TeguhTeknisi/ESP-Power-Monitor-with-INA226/README.md

# ESP-Power-Monitor-with-INA226
Bismillah

<b>ESP8266 Power Monitor with INA226</b> adalah alat ukur voltase, arus, daya dan energi dengan tambahan modul DHT11 untuk ukur temperatur dan kelembaban.
Alat ini dibuat sesuai kebutuhan sistem plts di tempat ana, dan ana tidak men jamin bisa jalan di tempat lain.
Alat ini kurang cocok untuk mengukur ke beban Inverter yang banyak Noise nya.

📣 Harus pakai Server Blynk Lokal , tutorial ada disini https://github.com/TeguhTeknisi/blynk-server
Sekedar info, ana install server blynk ke laptop ubuntu linux, tapi bisa juga di install ke android yang di instali linux.
Tambahan, Kalau mau pakai Server Online, silahkan modif codenya.

✔️ Kode dan Skema ada 2 versi:
1. versi 1 sensor, supaya lebih murah bisa pakai Modul Sensor INA226 dengan R Shunt R002 dengan kemampuan ukur continue 20 Ampere max 35 Volt.
   --> versi ini hanya mengukur 1 sumber saja, dan bisa hemat sekitar 80rb karena tidak perlu beli Modul INA226 yang kedua + R Shunt FL4.
2. versi 2 sensor, ini untuk yang ingin mengukur 2 sumber, seperti yang ana pakai, untuk ukur sumber dari Output Scc dan Baterai ke Beban. 
   --> Kemampuan Ukur pada Modul Sensor INA226 yang kedua ana tambahkan RShunt FL4 50A 75mV, sehingga bisa ukur beban sampai 50A 35 Volt
   --> Dengan R Shunt FL4 50A bisa 1.400 Watt untuk sistem 28 Volt yang ana pakai.
   --> Bisa diganti ke R Shunt 100A, 150A, 200A, 250A tapi harus ganti code nya dan hati hati jika bekerja dengan Arus besar.

⛔ Code harus di edit pada:
1. Auth Token Blynk
2. Nama SSID Hotspot dan Password nya.

📣 Untuk memudahkan kompile, sudah ana sediakan file <b>libraries.zip</b> dan <b>libraries.tar.gz</b> ( pilih salah satu, cuma beda ekstensi saja )
Isi file nya adalah library untuk Blynk, INA226, LCD I2C PCF8574 dan DHT11

📣 Untuk tingkat akurasinya sudah cukup bagus menurut ana, dengan membandingkan pengukuran arus dan voltase pakai multimeter Zoyi ZT102A
Karena R Shunt akan panas, jika arus besar lewat, maka panas nya akan menyebar ke chip ic INA226 itu akan membuat pengukuran voltase dari INA226 nya jadi tidak akurat, jadi Solusinya, ana tambahkan metode pengukuran memakai ADC dan untuk Solusi lain nya, R Shunt sebaiknya di jauhkan dari Chip IC INA226 dengan kabel yang panjangnya minimal 10cm sampai 15 cm )

📣 Untuk Sensor INA226 beli di link yang ana kasih dibawah, Insya Allah terjamin.
Untuk part lain, hanya sebagai referensi harga, ana tidak menjamin kualitasnya.

⛔ HATI HATI, ada modul INA226 Palsu, ana pernah beli dan gak bisa didetek I2C nya pakai I2C Scanner, tapi pas di ganti alamat ke 0x50 bisa detek tapi hanya tampil pengukuran Voltase tapi gak bisa dipakai buat ukur voltase.
NodeMCU dan Wemos D1 juga mulai muncul dengan raqgam kualitas yang gak bisa dilihat dari harga, bisa murah atau mahal.
Biasanya buat upload code akan sering error karena kualitas Chip Flash nya yang kurang bagus, atau yang parah gak bisa di program karena Chip Flash nya rusak.

✔️ Kemampuan membaca Voltase Max 35 volt, disarankan 30 Volt
✔️ Kemampuan membaca Arus tergantung nilai R Shunt.
Untuk Kode nya ana seting untuk:
1. Sensor 1 Continue max 20A, peak 25A pakai INA226 dengan R Shunt SMD R002
2. Sensor 2 Continue max 50A, pakai INA226 dengan RShunt SMD R100 yang di sambung ke R Shunt Eksternal FL4 50A 75mV

☑️ Kit ESP8266 bisa pakai Wemos D1 Mini agar kecil ringkas, atau pakai NodeMCU bentuk agak besar, ana pakai NodeMCU

☑️ Modul LCD 1602 pakai IC I2C PCF8574  untuk IC versi lain, silahkan memakai atau mencari library yang cocok.

☑️ Komponen Kapasitor 100nF fungsinya untuk filter, usahakan pakai Kapasitor Keramik, bisa Keramik biasa atau multilayer.

☑️ Komponen Dioda bisa pakai IN4001 sampai IN4007, untuk pengaman jika salah polaritas agar tidak rusak.

☑️ Modul DHT11 ana pakai untuk mengukur temperature dan kelembaban di dalam box plts, bisa dipakai atau gak dipakai.

✔️ Untuk Codenya ana ambil dari berbagai tempat, sumbernya ada dibawah ini:
1. https://forum.arduino.cc/t/solar-power-monitor-w-ina226-and-esp8266-v1/649695
2. https://community.blynk.cc/t/power-monitor-dc-current-and-voltage-sensor-ina219/10297 ( referensi code max voltase, arus dan daya )
3. https://www.engineersgarage.com/nodemcu-battery-voltage-monitor/ ( referensi alat ukur voltase pakai resistor divider )
4. https://how2electronics.com/iot-based-battery-status-monitoring-system-using-esp8266/ ( referensi alat ukur voltase pakai resistor divider )
5. https://openenergymonitor.org/forum-archive/node/198.html ( referensi kwh meter dan log harian )

✔️ Part list
1. Sensor 1 pakai INA226 20A 36v - https://shopee.co.id/product/43270505/8591547022?smtt=0.94966776-1646228655.9 ( 49rb )

Alternatif nya
INA226 maks 36v 1A - https://shope.ee/6pZNHZQZvh?share_channel_code=2
INA219 maks 26v 3,2A - https://shope.ee/6fFx5JUKef?share_channel_code=2

2. Sensor 2 pakai INA226 1A 36v - https://shope.ee/6pZNHZQZvh?share_channel_code=2
INA219 maks 26v 3,2A - https://shope.ee/6fFx5JUKef?share_channel_code=2

3. LCD 1602 - 
https://shope.ee/8A4ksROCPI?share_channel_code=2 ( 37rb )

4. Wemos D1 Mini - https://shope.ee/VfJkTWUDK?share_channel_code=2 ( 42rb )

5. R Shunt 50A FL4 untuk Sensor 2 - https://shope.ee/5KkZVU27kJ?share_channel_code=2 ( 30rb )

6. LM 7805 - https://www.tokopedia.com/search?st=product&q=LM7805 ( 1.400 )

7. Kapasitor Keramik 100nf 104 - https://www.tokopedia.com/lisuinstrument/0-1uf-100nf-50v-104-multilayer-monolithic-ceramic-capacitor ( 300 x 3 = 900 )

8. Resistor 100K - https://www.tokopedia.com/isee/10-pcs-resistor-100k-100-kilo-ohm-1-4-watt-0-25-metal-film-1-toleran ( 10pcs - 1.000 )

9. Resistor 10K - https://www.tokopedia.com/isee/10-pcs-resistor-10k-10-kilo-ohm-1-4-watt-0-25-metal-film-1-toleran ( 10pcs - 1.000 )

10. Dioda 1A - https://www.tokopedia.com/lisuinstrument/in4001-1n4001-4001-general-purpose-plastic-rectifier-do-41 ( 200 )

11. pcb berlubang - https://www.tokopedia.com/isee/pcb-dot-matrix-ic-type-5x7-5-x-7-pcb-lubang-ic-5-7-cm ( 2.400 )

12. Sensor DHT11 - https://www.tokopedia.com/best-ay/modul-dht11-sensor-kelembaban-suhu-humidity-temperature-digital ( 14.950 )

☑️ Estimasi Total Biaya per Juni 2022 ( bisa berubah seiring berjalannya waktu ):

🟠 Untuk 1 Sensor Rp. 139.000 sampai Rp. 147.500 ( belum timah, box, kabel, dll )

🔴 Untuk 2 Sensor Rp. 215.000 sampai Rp. 223.500 ( belum timah, box, kabel, dll )

⛔ Untuk pengukuran diatas 12v, Harus mengganti ic regulator LM7805 diganti modul step down 5v
karena ic LM7805 jika diberi voltase input diatas 12v akan kepanasan, jika dibiarkan lama, bisa merusak Nodemcu.

🔴🟠 Resistor 100K bisa ganti 120K agar maks ukur jadi 43v tapi harus modif code nya dan ic regulator LM7805 diganti modul step down 5v
karena ic LM7805 jika diberi voltase input diatas 12v akan kepanasan, jika dibiarkan lama, bisa merusak Nodemcu.

<b>Foto Foto Prototype:</b>

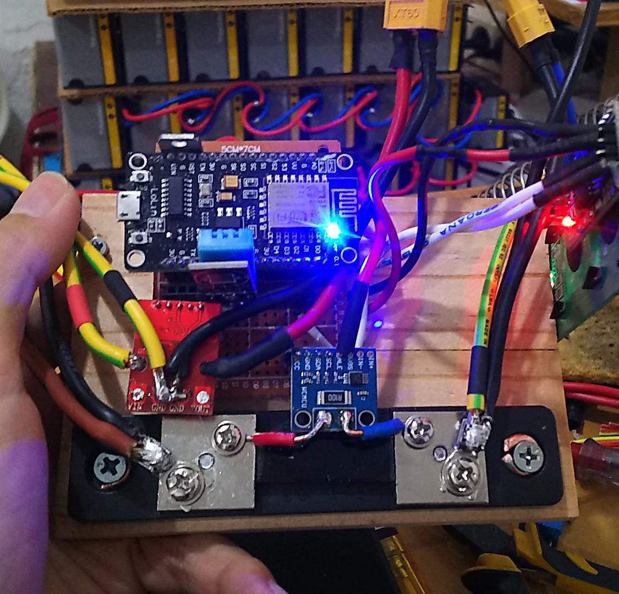
[picture p1: ESP Power Monitor Prototype 1.jpeg]

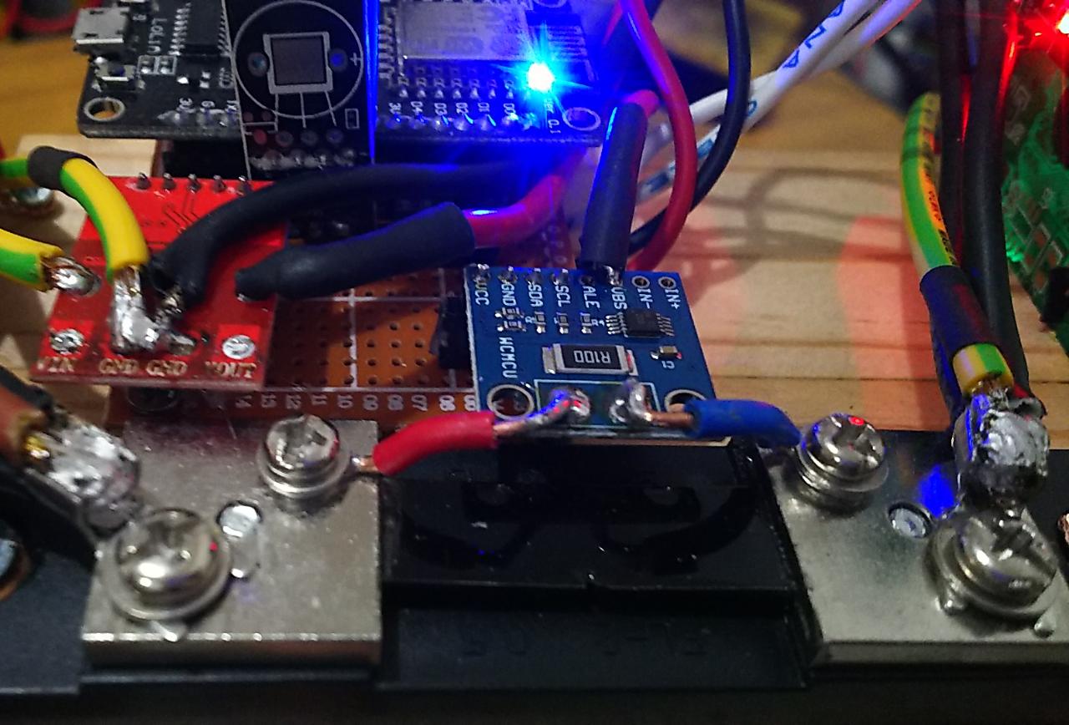
[picture p2: ESP Power Monitor Prototype 2.jpeg]

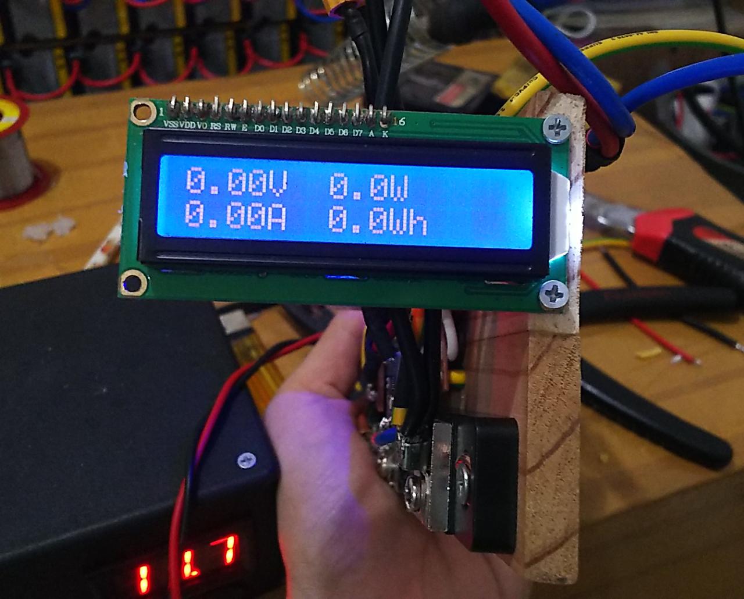
[picture p3: ESP Power Monitor Prototype 3.jpeg]

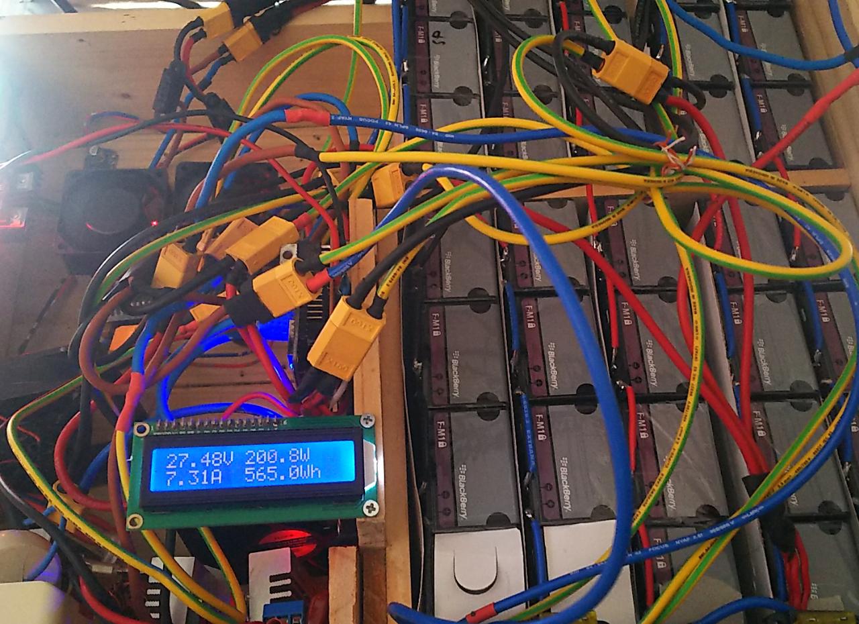
[picture p4: ESP Power Monitor Prototype Tes.jpeg]

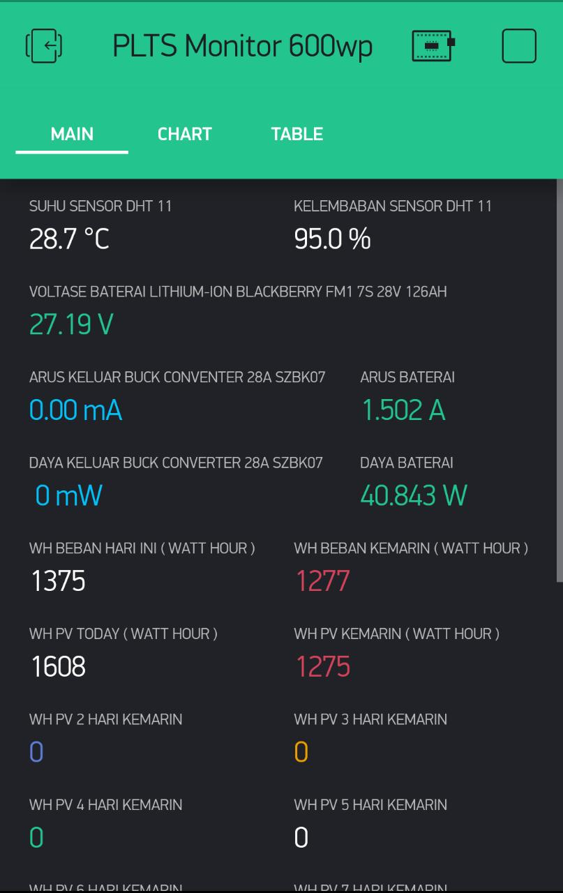
[picture p5: ESP Power Monitor Prototype Blynk.jpeg]

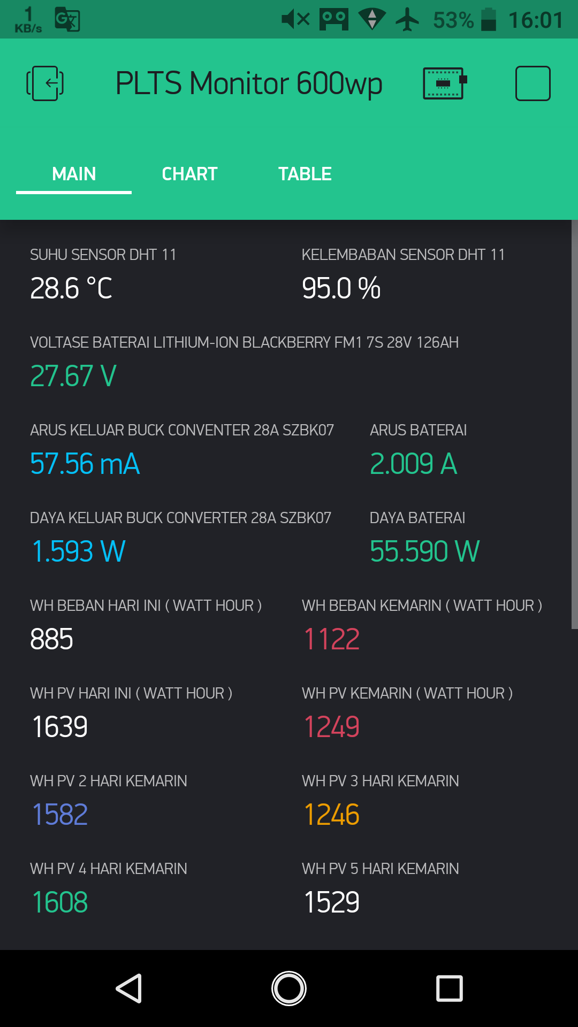
[picture p6: ESP Power Monitor Prototype Blynk 2.png]


<b>Video tampilan Blynk Prototype:</b>
<video src="https://user-images.githubusercontent.com/32675055/159250105-12d3eaf4-a2be-465b-95e1-02a9efdc0cbc.mp4"></video>

Semoga membantu dan bermanfaat.
