TeguhTeknisi/ESP-Power-Monitor-with-INA226/ESP Power Monitor Skema 2.png

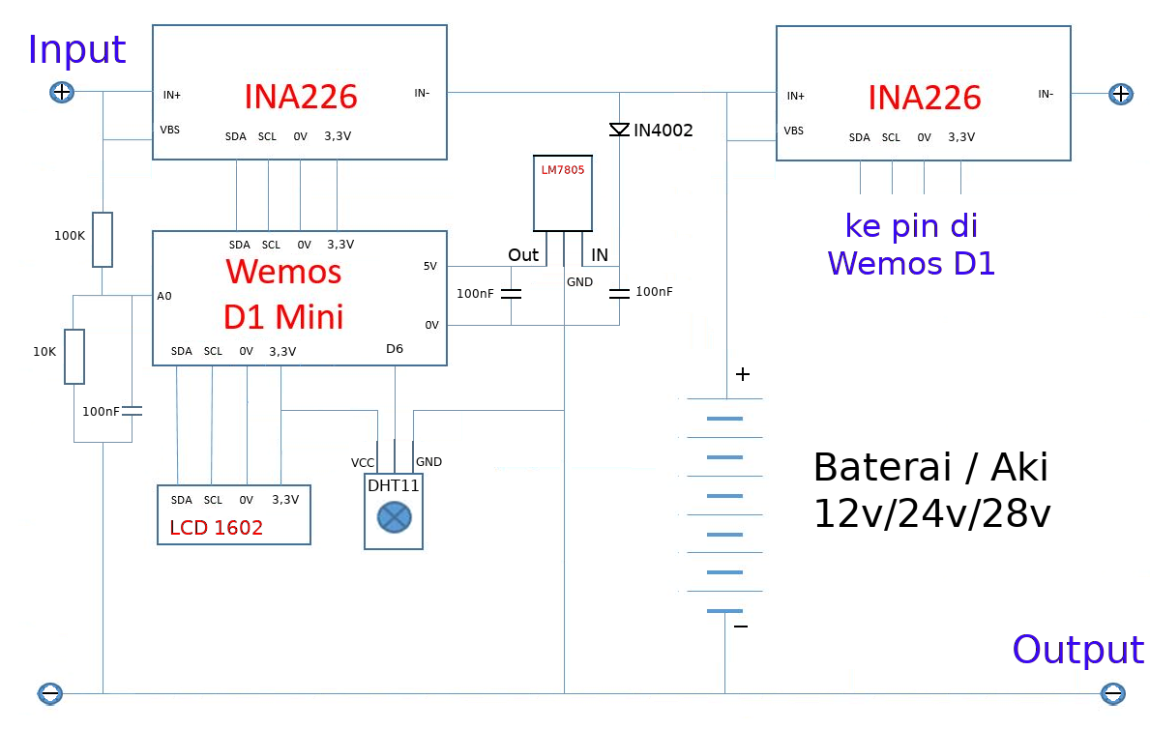
ESP Power Monitor Skema 2.png
