TeguhTeknisi/ESP-Power-Monitor-with-INA226/ESP Power Monitor Skema.png

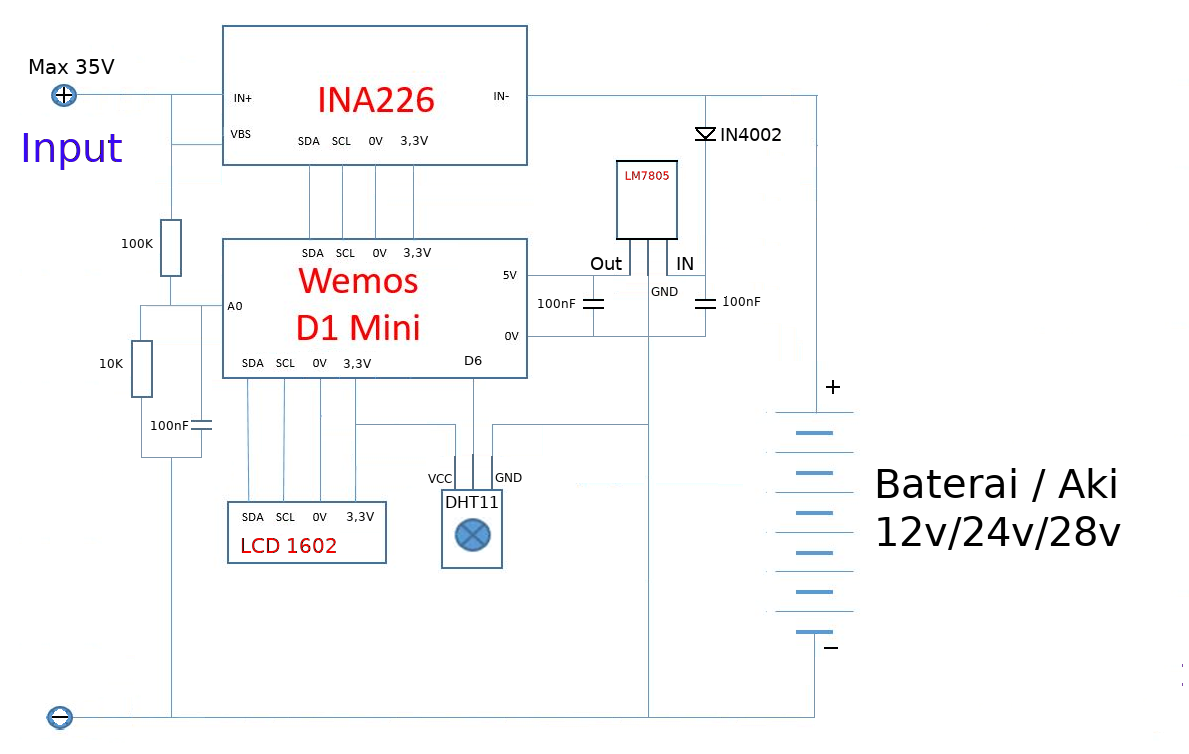
ESP Power Monitor Skema.png
