TeguhTeknisi/ESP-Power-Monitor-with-INA226/(commit log)

2022-03-02 Add files via upload
    Skema versi satu sensor
2022-03-02 Add files via upload
    Skema versi dengan 2 sensor INA226
2022-03-02 Create ESP_Power_Monitor_with_INA226 versi 2 sensor.ino
    Ini code buat ESP Power Monitor dengan 2 sensor INA226
2022-03-03 Add files via upload
    File Library untuk:
    1. Blynk
    2. DHT11
    3. INA226
    4. LCD I2C 16x2 ( 1602 )
2022-03-03 Add files via upload
    Foto foto Prototype
2022-05-29 Update ESP_Power_Monitor_with_INA226 versi 2 sensor.ino
2022-05-29 Update ESP_Power_Monitor_with_INA226.ino
    fix typo
    [ESP_Power_Monitor_with_INA226.ino]
2022-07-27 Update README.md
    Penambahan informasi masalah ketidak akuratan pengukuran voltase yang disebabkan panas dari R Shunt
